samareosa-cloud/2026ESWContest_free_JOJOLEEHAN/(commit log)

2026-09-02 Add ESP32 firmware
2026-09-02 Create Raspberry Pi software directory
2026-09-02 Add Raspberry Pi AI vision software
